ryanmccormickdev/collier-gloves/media/2026-05-09-0328-perfboard-back.jpg

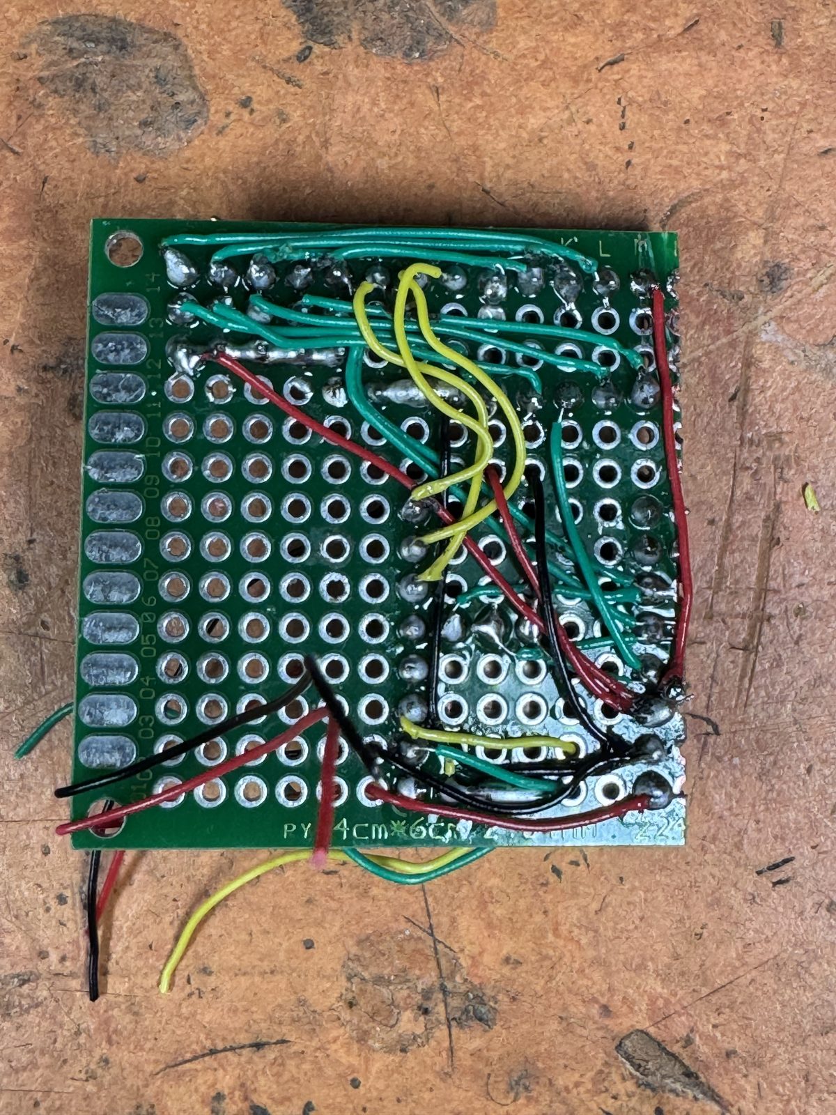
media/2026-05-09-0328-perfboard-back.jpg
