ryanmccormickdev/collier-gloves/media/2026-05-09-0454-stack-top.jpg

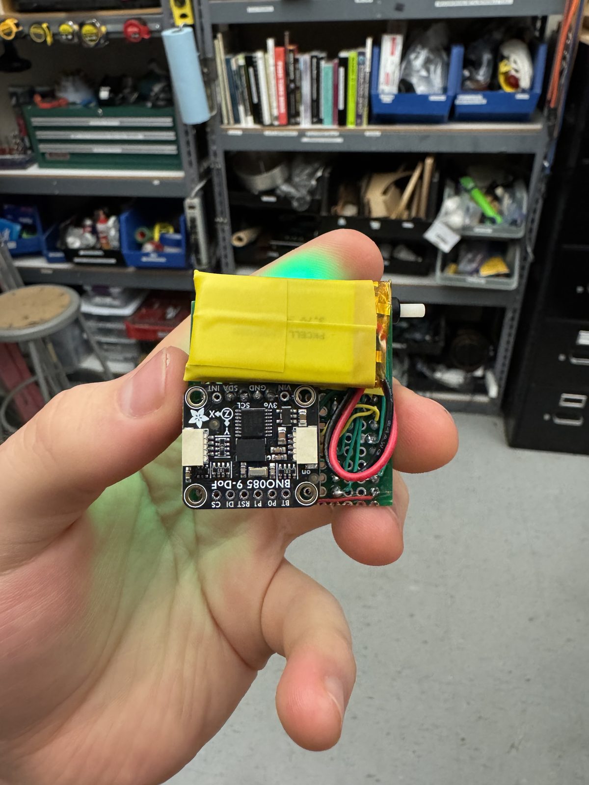
media/2026-05-09-0454-stack-top.jpg
