ryanmccormickdev/collier-gloves/media/commit-clock-dark.png

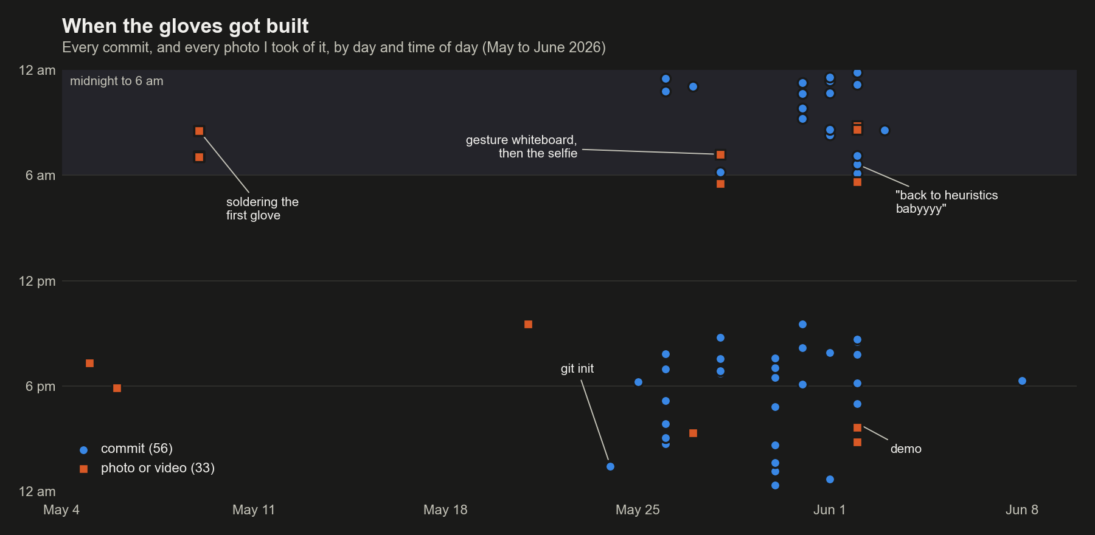
media/commit-clock-dark.png
