ryanmccormickdev/collier-gloves/experiments/arduino-sketches/glove_experiments/glove_experiments.ino

#include <Wire.h>

#define SDA_PIN 8
#define SCL_PIN 9

void setup() {
  Serial.begin(115200);
  delay(2000);  // give USB CDC time to come up
  Wire.begin(SDA_PIN, SCL_PIN);
  Serial.println("Scanning I2C...");
  for (byte addr = 1; addr < 127; addr++) {
    Wire.beginTransmission(addr);
    if (Wire.endTransmission() == 0) {
      Serial.printf("Found device at 0x%02X\n", addr);
    }
  }
  Serial.println("Done.");
}

void loop() {}
